rrruark/IOT_Geiger/README.md

http://robruark.com/other/Radiation/Geiger_Counter/v2/geiger_v23.html
