rrruark/IOT_Geiger/Geiger_v3.pdf

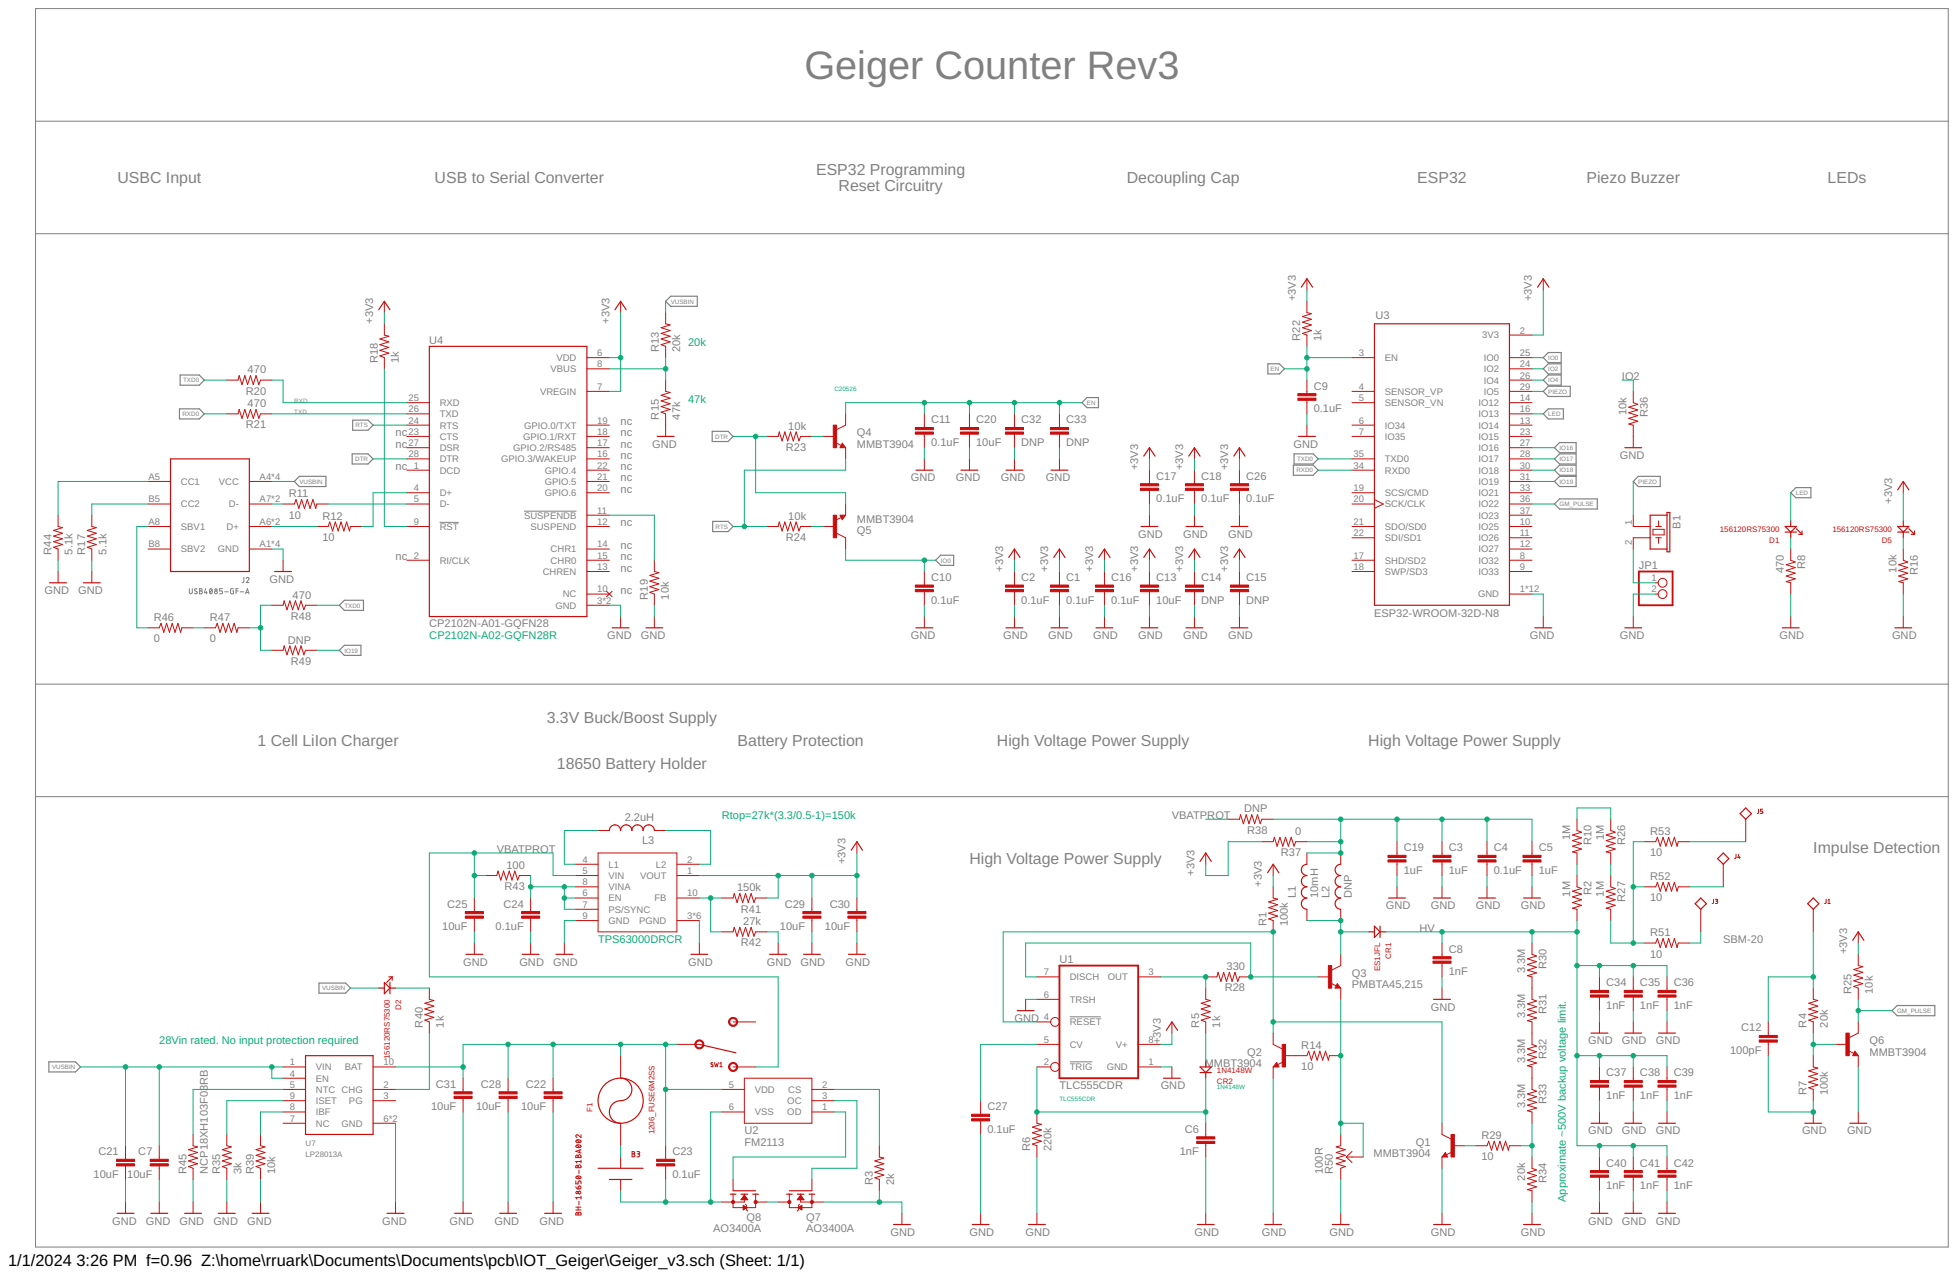
[picture p1: page 1]

High Voltage Power Supply

Approximate ~500V backup voltage limit.

1N4148W 28Vin rated. No input protection required

1/1/2024 3:26 PM f=0.96 Z:\home\rruark\Documents\Documents\pcb\IOT_Geiger\Geiger_v3.sch (Sheet: 1/1)
