rrruark/IOT_Geiger/rev3/Geiger_v3.pdf

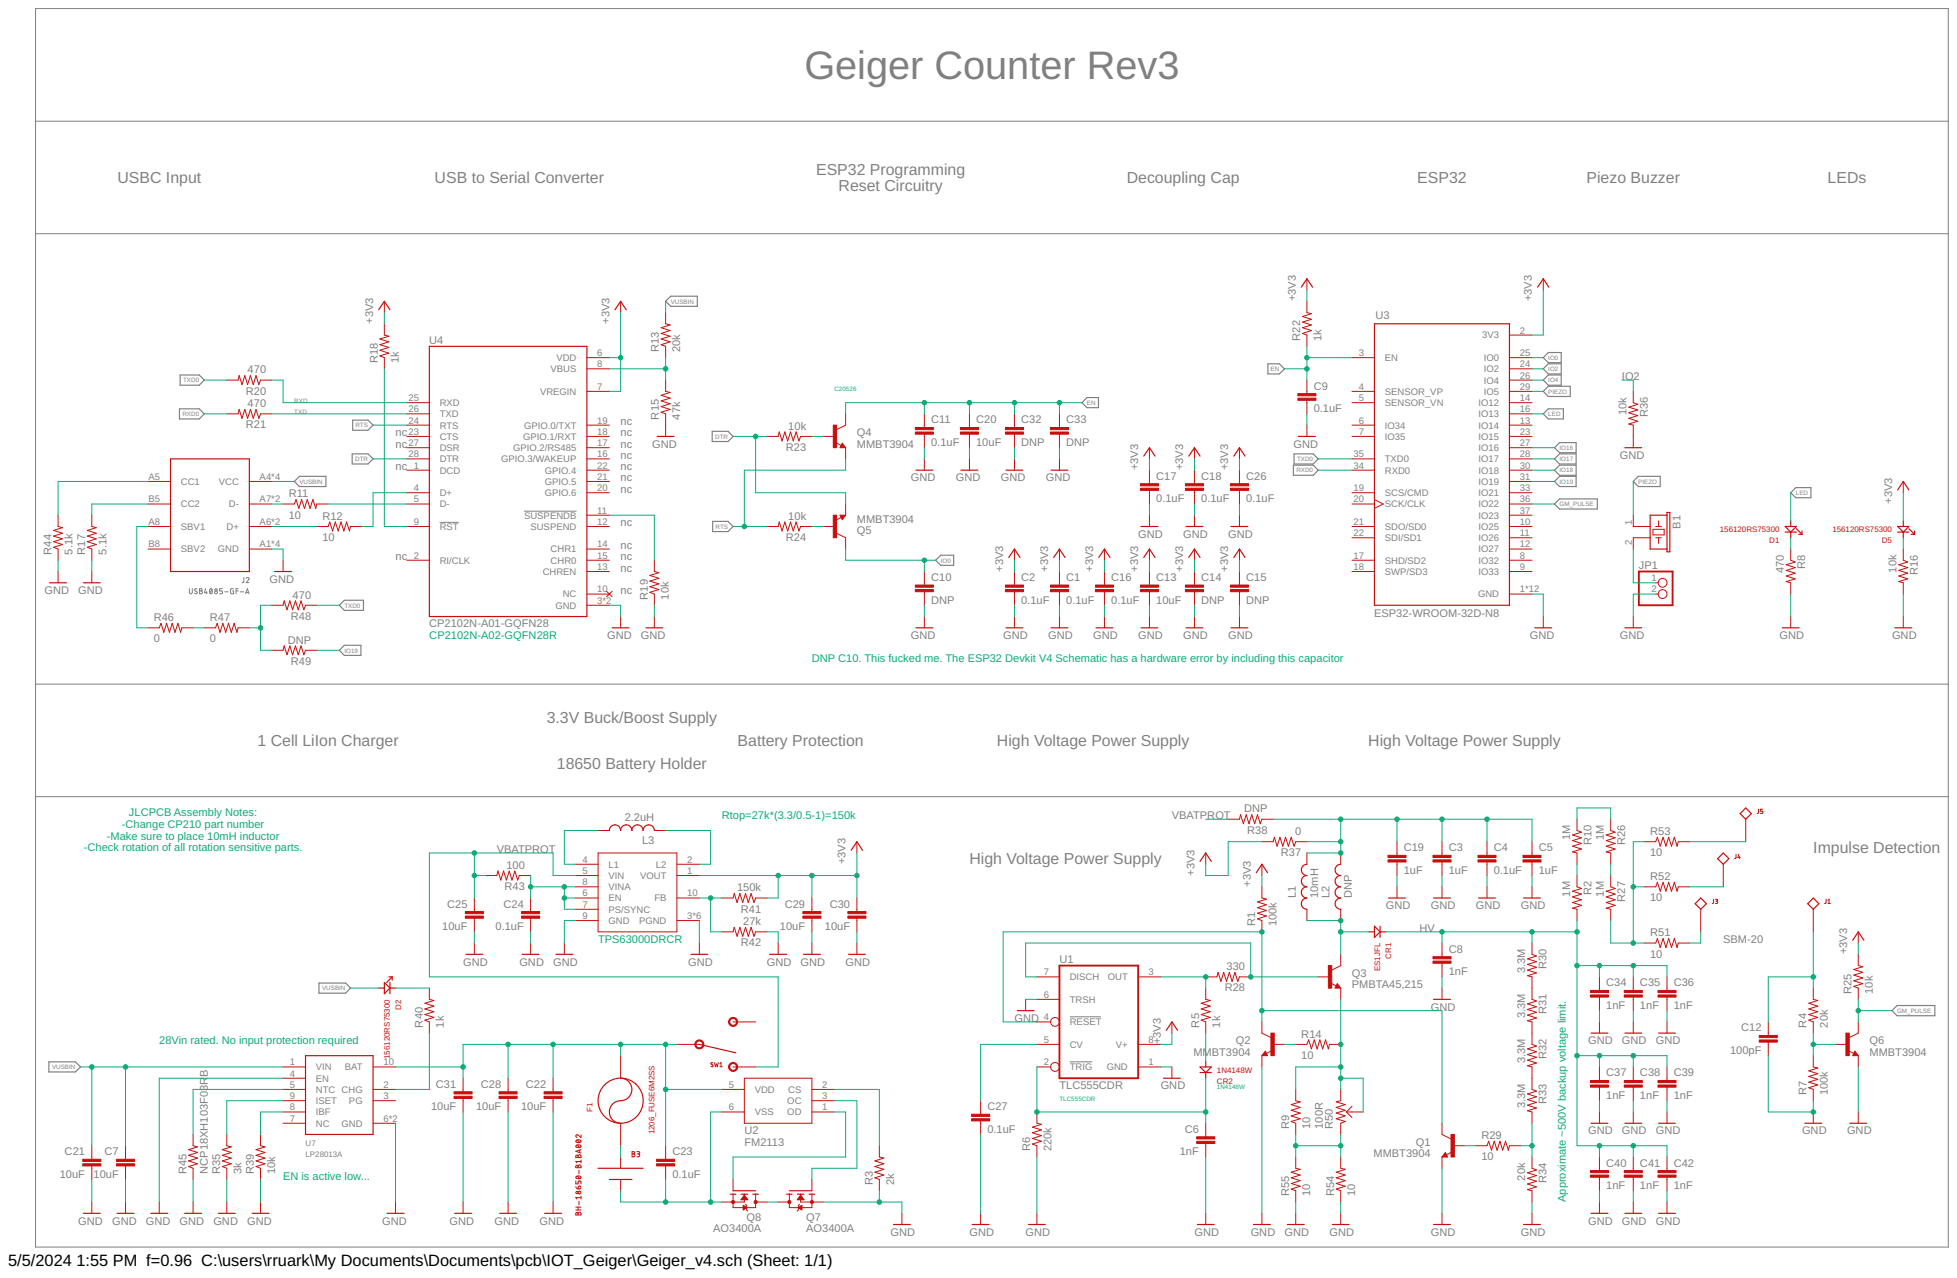
[picture p2: page 1]

DNP C10. This fucked me. The ESP32 Devkit V4 Schematic has a hardware error by including this capacitor

JLCPCB Assembly Notes: -Change CP210 part number

-Make sure to place 10mH inductor
-Check rotation of all rotation sensitive parts.

High Voltage Power Supply

Approximate ~500V backup voltage limit.

1N4148W 28Vin rated. No input protection required

EN is active low...

5/5/2024 1:55 PM f=0.96 C:\users\rruark\My Documents\Documents\pcb\IOT_Geiger\Geiger_v4.sch (Sheet: 1/1)
