rrruark/IOT_Geiger/rev2/Geiger_rev2.pdf

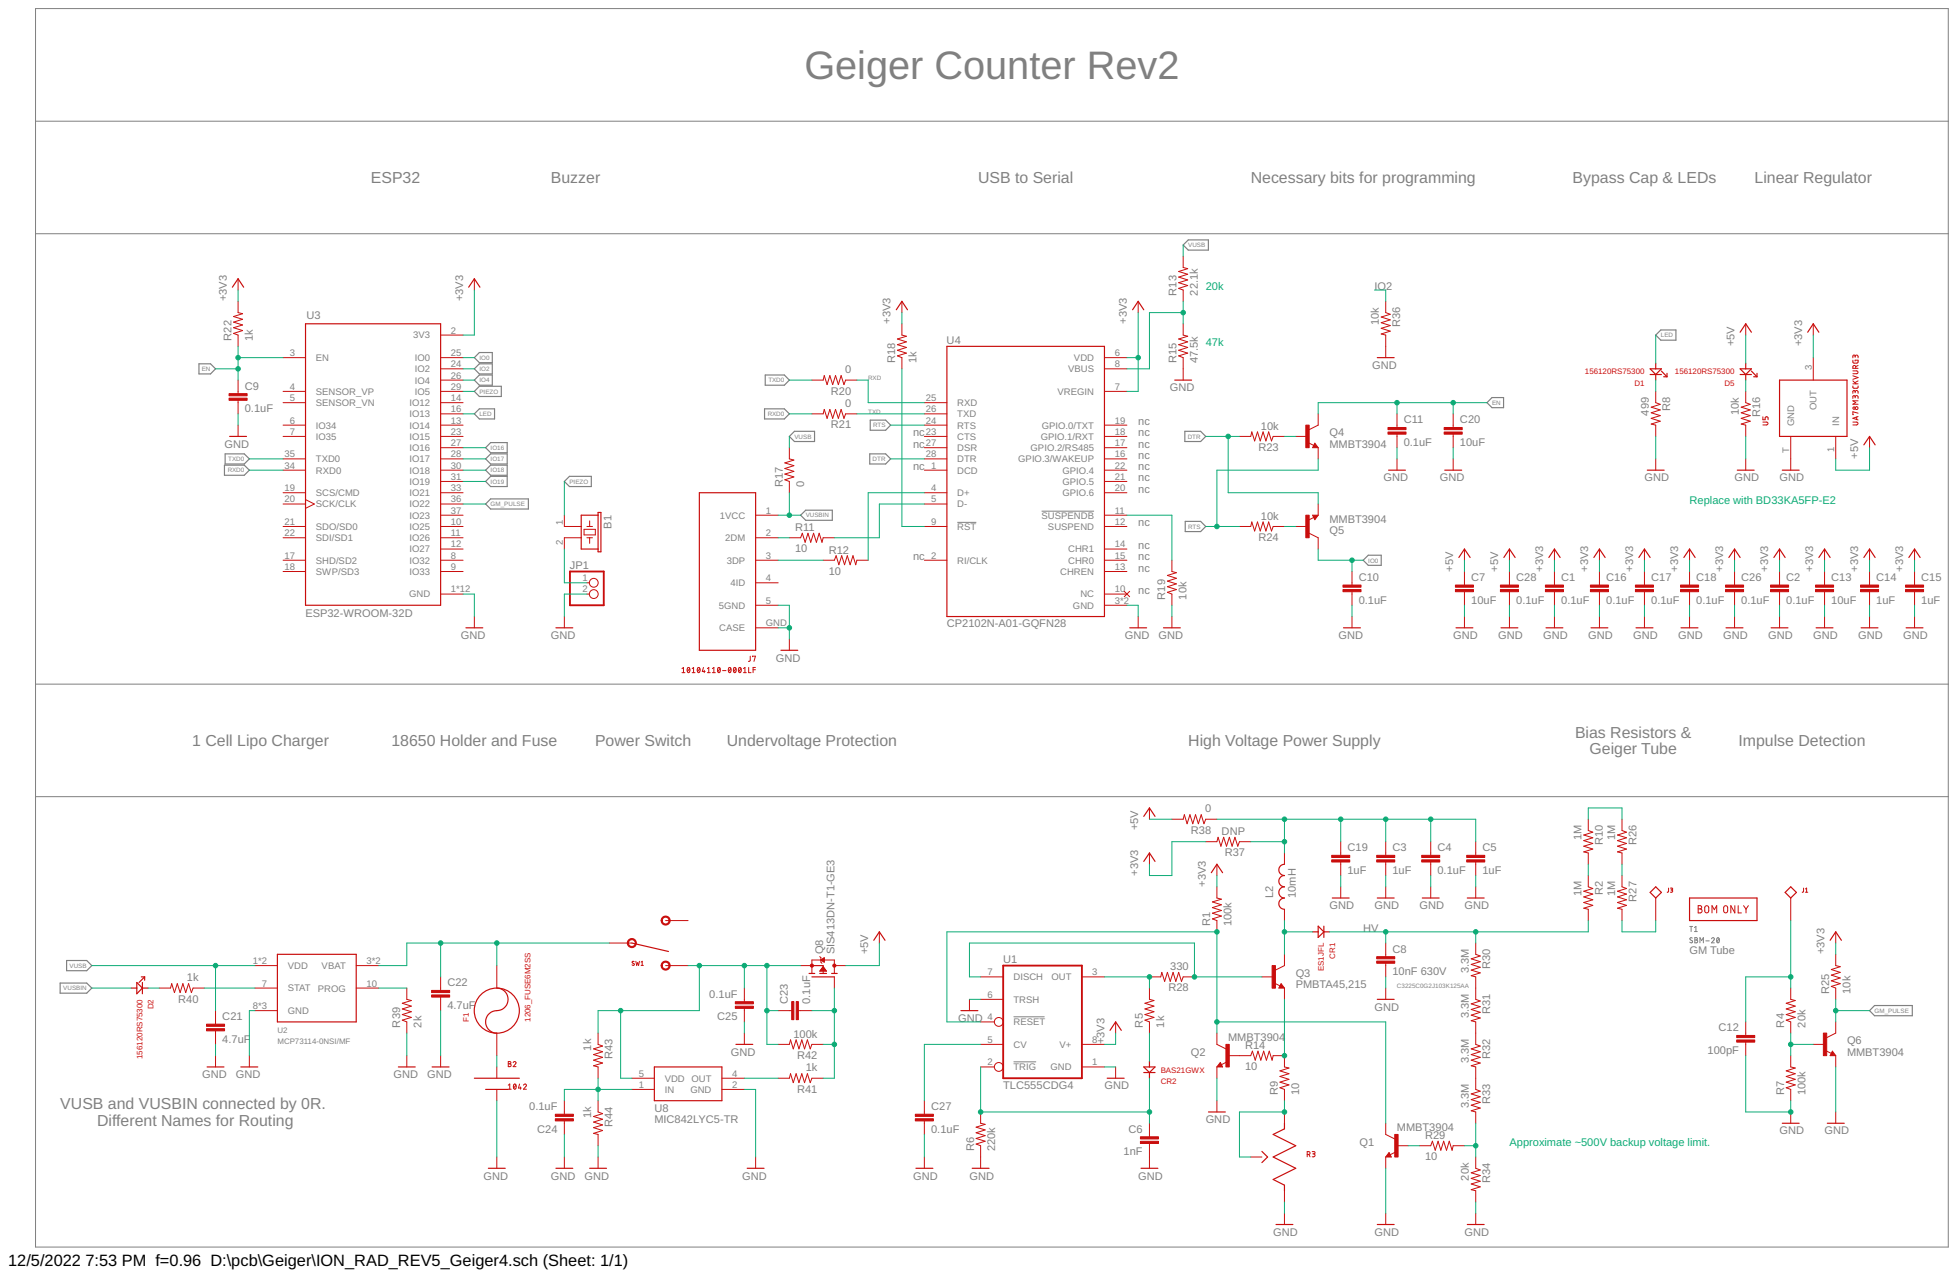
[picture p3: page 1]

VUSB and VUSBIN connected by 0R. Different Names for Routing

Approximate ~500V backup voltage limit.

12/5/2022 7:53 PM f=0.96 D:\pcb\Geiger\ION_RAD_REV5_Geiger4.sch (Sheet: 1/1)
