rrruark/IOT_Geiger/rev1/Geiger_Rev1.pdf

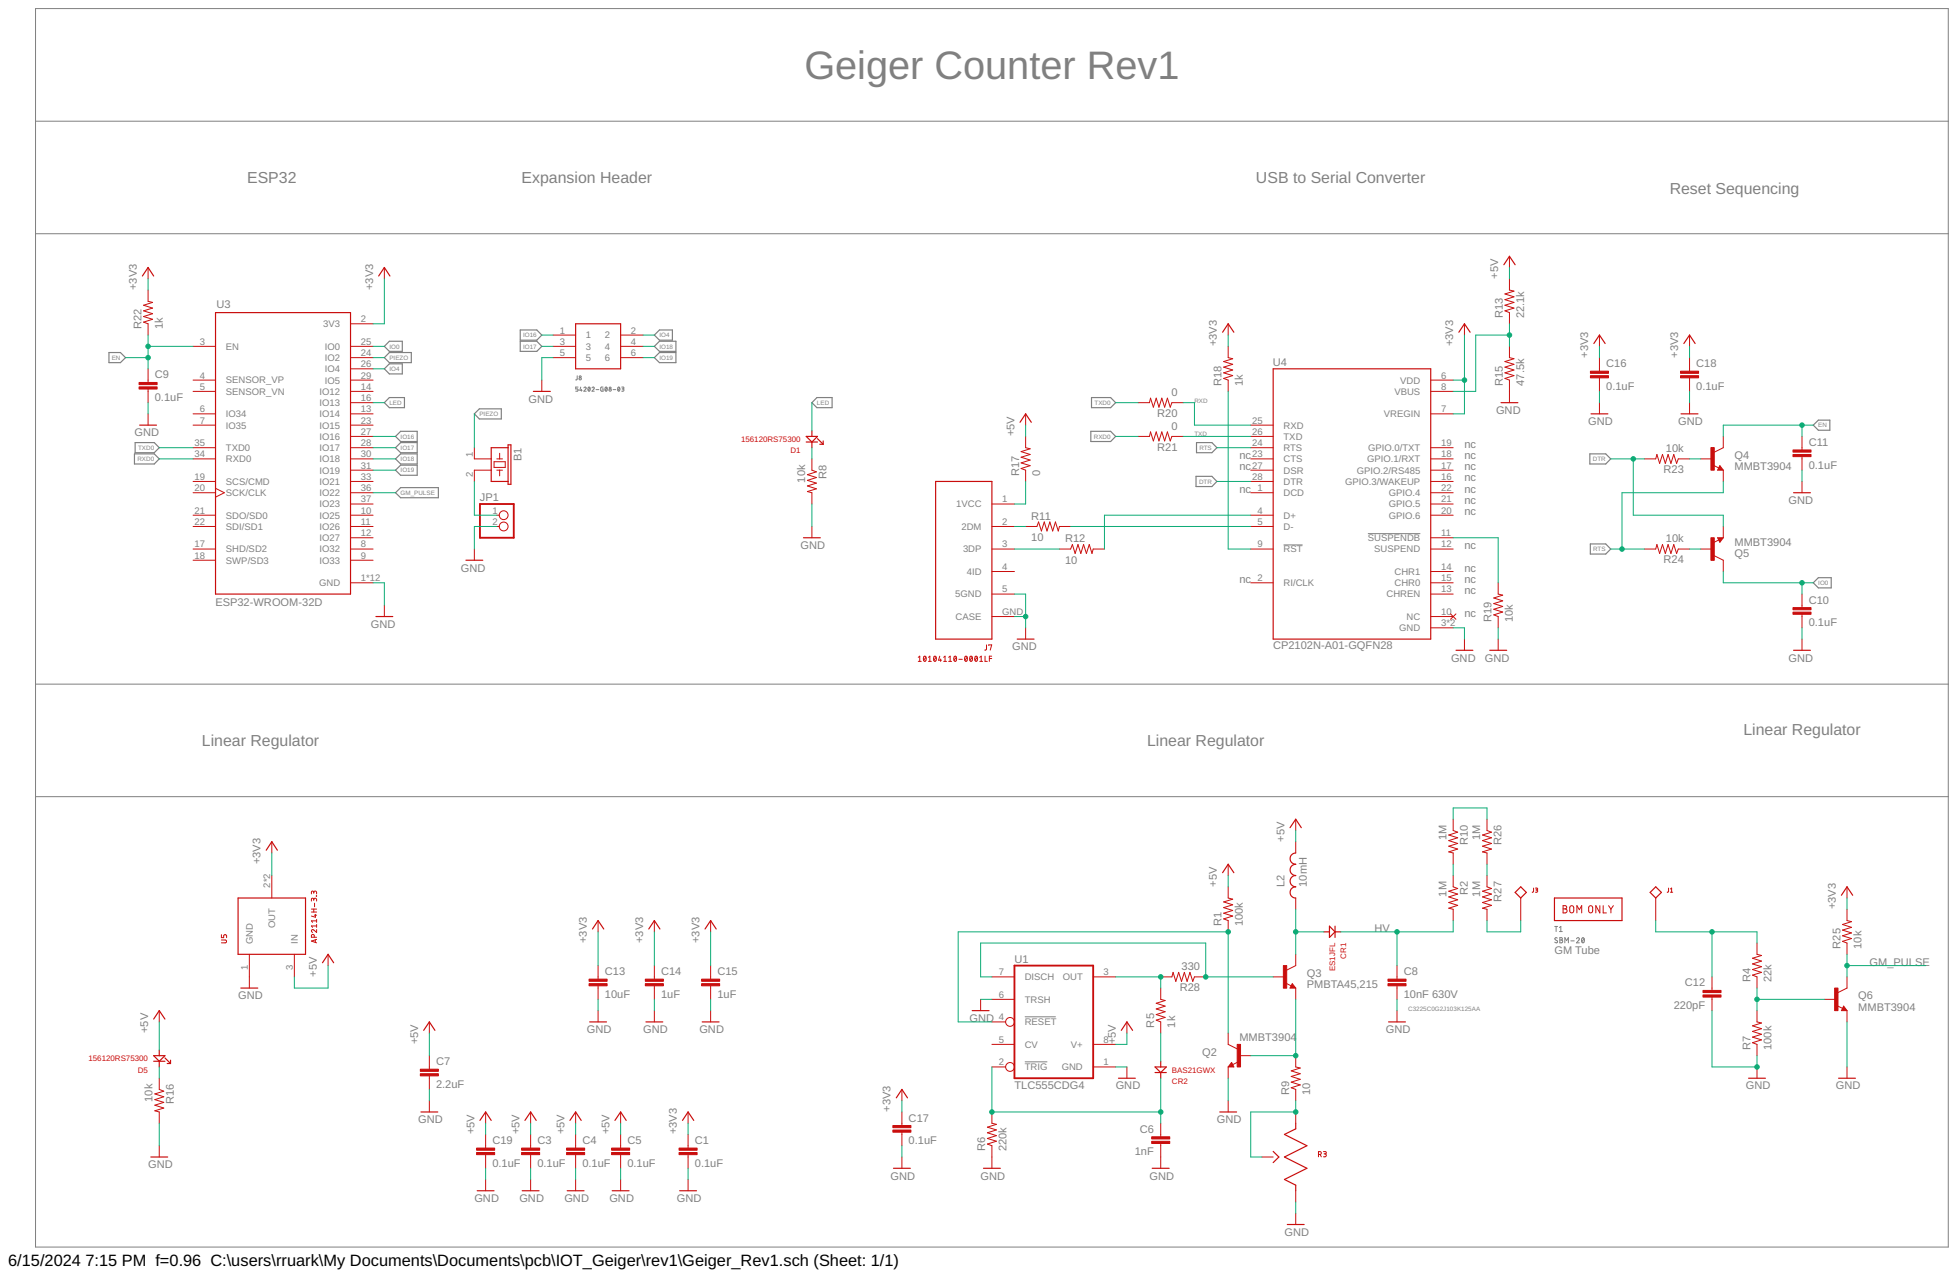
[picture p4: page 1]

6/15/2024 7:15 PM f=0.96 C:\users\rruark\My Documents\Documents\pcb\IOT_Geiger\rev1\Geiger_Rev1.sch (Sheet: 1/1)
