rrruark/IOT_Geiger/rev1/Geiger_Rev1.brd

## EAGLE design rev1/Geiger_Rev1.brd (2024-06-16, an earlier design)

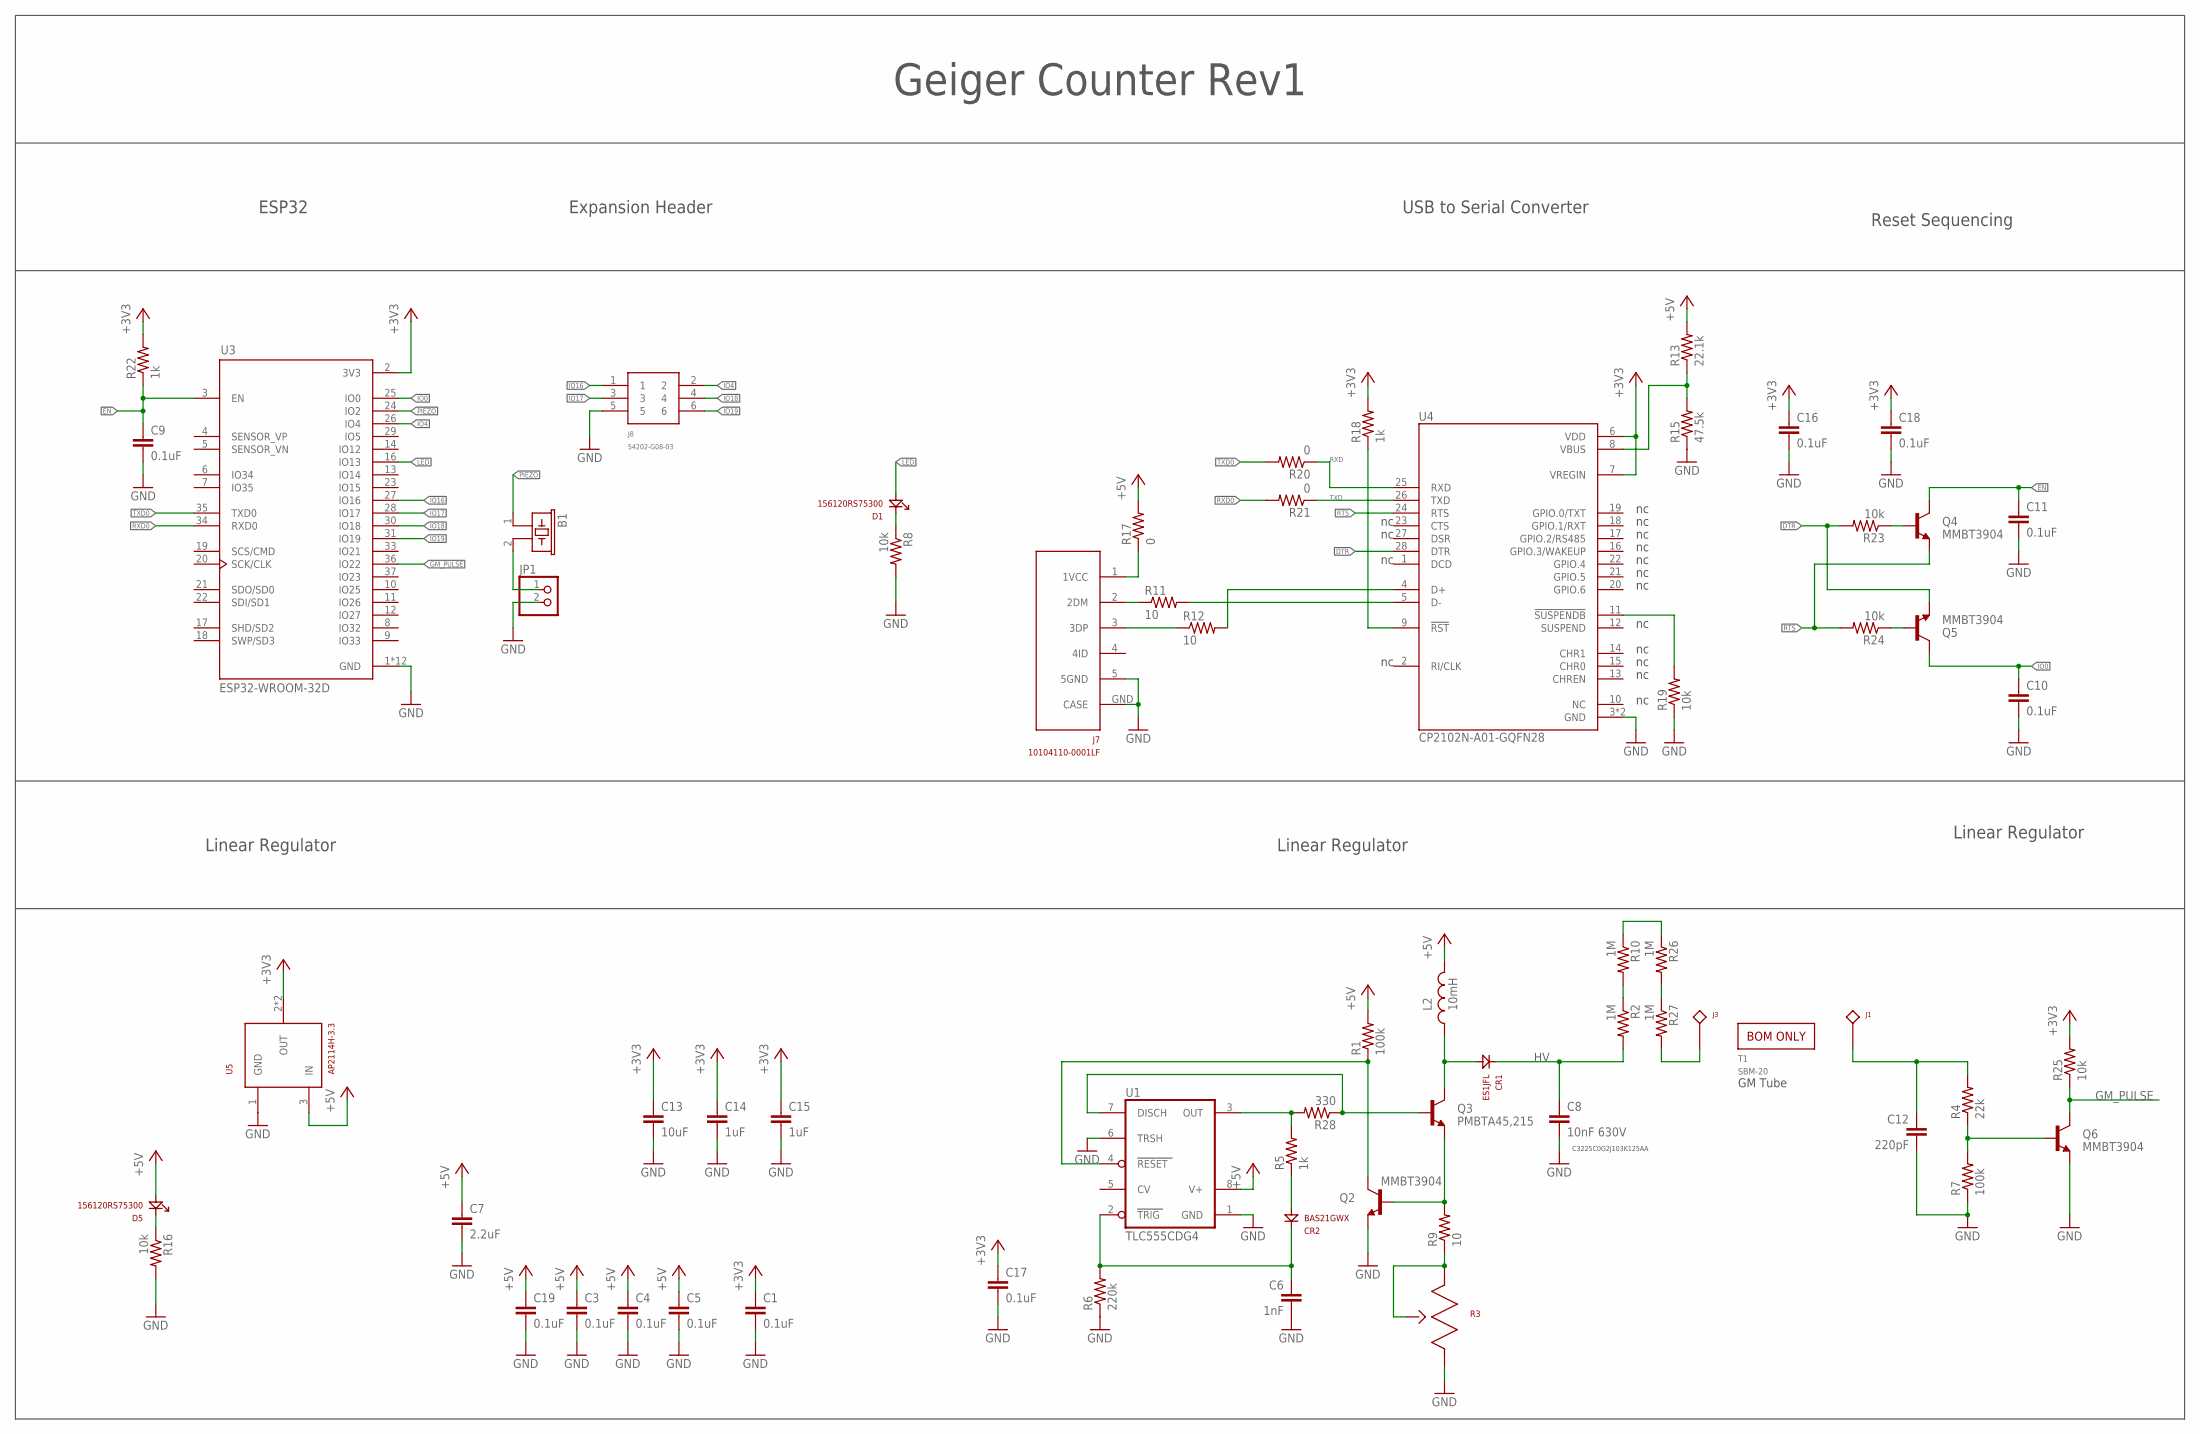
[picture p5: schematic Geiger_Rev1.sch]

Parts:
B1: PIEZO17MM; PS1740P02E
C1, C3, C4, C5, C9, C10, C11, C16, C17, C18, C19: 0.1uF; 0603
C6: 1nF; 0603
C7: 2.2uF; 1210
C8: 10nF 630V; 1210
C12: 220pF; 0603
C13: 10uF; 0805
C14, C15: 1uF; 0805
CR1: ES1JFL; SOD123(AK)
CR2: BAS21GWX; SOD123
D1, D5: 156120RS75300; 1206_REV
J1, J3: 01010002Z
J7: 10104110-0001LF; MICRO_USB
J8: 54202-G08-03; 6-SMT-HEADER
JP1: PINHD-1X2; 1X02
L2: 10mH; SDR1005
Q2, Q4, Q5, Q6: MMBT3904; SOT23-3
Q3: PMBTA45,215; SOT23-3
R1, R7: 100k; 0603
R2, R10, R26, R27: 1M; 0603
R3: 10; 3361P
R4: 22k; 0603
R5, R18, R22: 1k; 0603
R6: 220k; 0603
R8, R16, R19, R23, R24, R25: 10k; 0603
R9: 10; 1206
R11, R12: 10; 0603
R13: 22.1k; 0603
R15: 47.5k; 0603
R17, R20, R21: 0; 0603
R28: 330; 0603
T1: SBM-20
U1: TLC555CDG4; SOIC8
U3: ESP32-WROOM-32D; MODULE_ESP32-WROOM-32D
U4: CP2102N-A01-GQFN28; QFN50P500X500X80-29N
U5: AP2114H-3.3; SOT223

Connections:
+3V3: C1.1, C13.1, C14.1, C15.1, C16.1, C17.1, C18.1, R18.2, R22.2, R25.2, U3.2 (3V3), U4.6 (VDD), U4.7 (VREGIN), U5.2 (OUT), U5.T (OUT)
+5V: C3.1, C4.1, C5.1, C7.1, C19.1, D5.A, L2.P$2, R1.2, R13.2, R17.2, U1.8 (V+), U5.3 (IN)
DTR: Q5.2 (E), R23.2, U4.28 (DTR)
EN: C9.1, C11.1, Q4.3 (C), R22.1, U3.3 (EN)
GM_PULSE: Q6.3 (C), R25.1, U3.36 (IO22)
GND: C1.2, C3.2, C4.2, C5.2, C6.2, C7.2, C8.2, C9.2, C10.2, C11.2, C12.2, C13.2, C14.2, C15.2, C16.2, C17.2, C18.2, C19.2, J7.5 (5GND), J7.GND (CASE), J8.5, JP1.2, Q2.2 (E), Q6.2 (E), R3.3, R6.1, R7.1, R8.2, R15.1, R16.2, R19.1, U1.1 (GND), U1.6 (TRSH), U3.1 (GND), U3.15 (GND), U3.38 (GND), U3.39_1 (GND), U3.39_2 (GND), U3.39_3 (GND), U3.39_4 (GND), U3.39_5 (GND), U3.39_6 (GND), U3.39_7 (GND), U3.39_8 (GND), U3.39_9 (GND), U4.3 (GND), U4.29 (GND), U5.1 (GND)
HV: C8.1, CR1.K, R2.2
IO0: C10.1, Q5.3 (C), U3.25 (IO0)
IO4: J8.2, U3.26 (IO4)
IO16: J8.1, U3.27 (IO16)
IO17: J8.3, U3.28 (IO17)
IO18: J8.4, U3.30 (IO18)
IO19: J8.6, U3.31 (IO19)
LED: D1.A, U3.16 (IO13)
unnamed: CR2.2 (A), R5.1
unnamed: J7.2 (2DM), R11.1
unnamed: Q2.3 (C), R1.1, U1.4 (RESET)
unnamed: J7.3 (3DP), R12.1
unnamed: R11.2, U4.5 (D-)
unnamed: R12.2, U4.4 (D+)
unnamed: R13.1, R15.2, U4.8 (VBUS)
unnamed: Q3.1 (B), R28.1, U1.7 (DISCH)
unnamed: C6.1, CR2.1 (K), R6.2, U1.2 (TRIG)
unnamed: R5.2, R28.2, U1.3 (OUT)
unnamed: Q2.1 (B), Q3.2 (E), R9.2
unnamed: B1.2, JP1.1
unnamed: J7.1 (1VCC), R17.1
unnamed: Q6.1 (B), R4.1, R7.2
unnamed: J3.P$1, R27.2
unnamed: R2.1, R10.2
unnamed: R10.1, R26.1
unnamed: R18.1, U4.9 (!RST)
unnamed: D5.K, R16.1
unnamed: R19.2, U4.11 (!SUSPENDB)
unnamed: R26.2, R27.1
unnamed: Q4.1 (B), R23.1
unnamed: R3.1, R3.2, R9.1
unnamed: Q5.1 (B), R24.1
unnamed: D1.K, R8.1
unnamed: C12.1, J1.P$1, R4.2
PIEZO: B1.1, U3.24 (IO2)
RTS: Q4.2 (E), R24.2, U4.24 (RTS)
RXD: R20.1, U4.25 (RXD)
RXD0: R21.2, U3.34 (RXD0)
SW: CR1.A, L2.P$1, Q3.3 (C)
TXD: R21.1, U4.26 (TXD)
TXD0: R20.2, U3.35 (TXD0)

Notes on the sheet:
Geiger Counter Rev1
Linear Regulator
GM Tube
C3225C0G2J103K125AA
ESP32
Expansion Header
USB to Serial Converter
Reset Sequencing

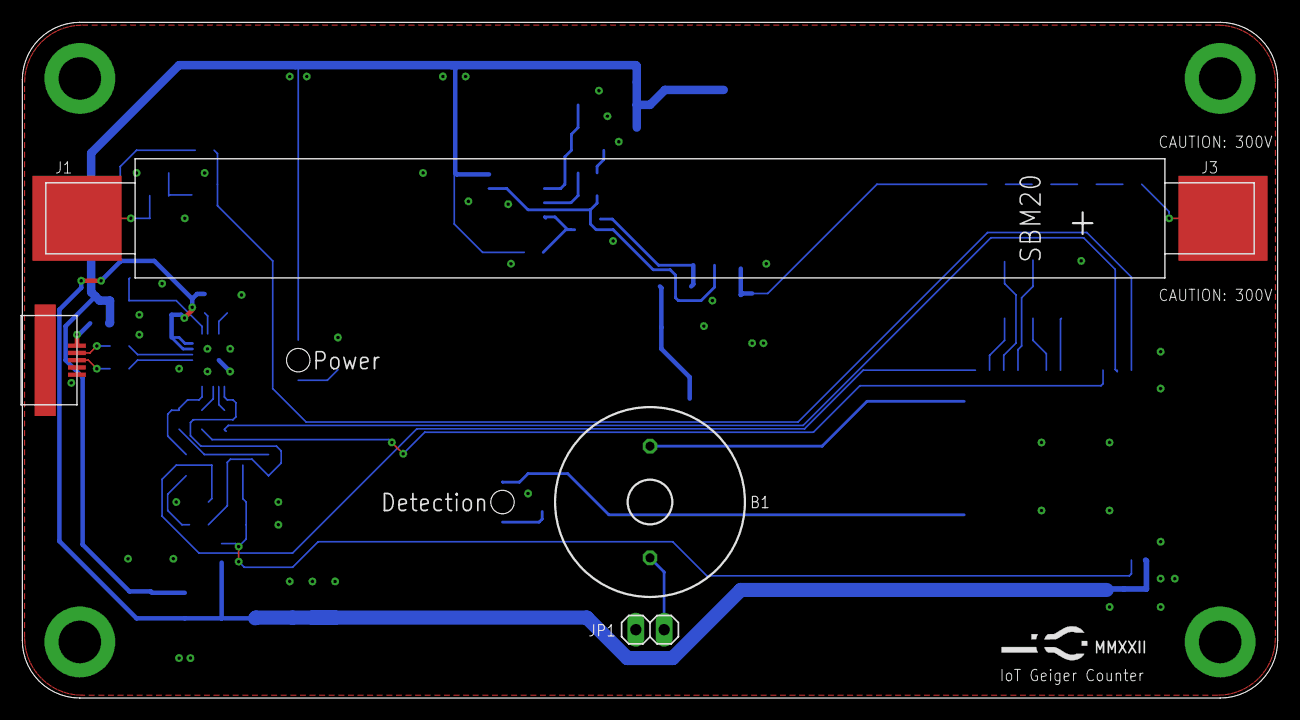
[picture p6: board Geiger_Rev1.brd from above]

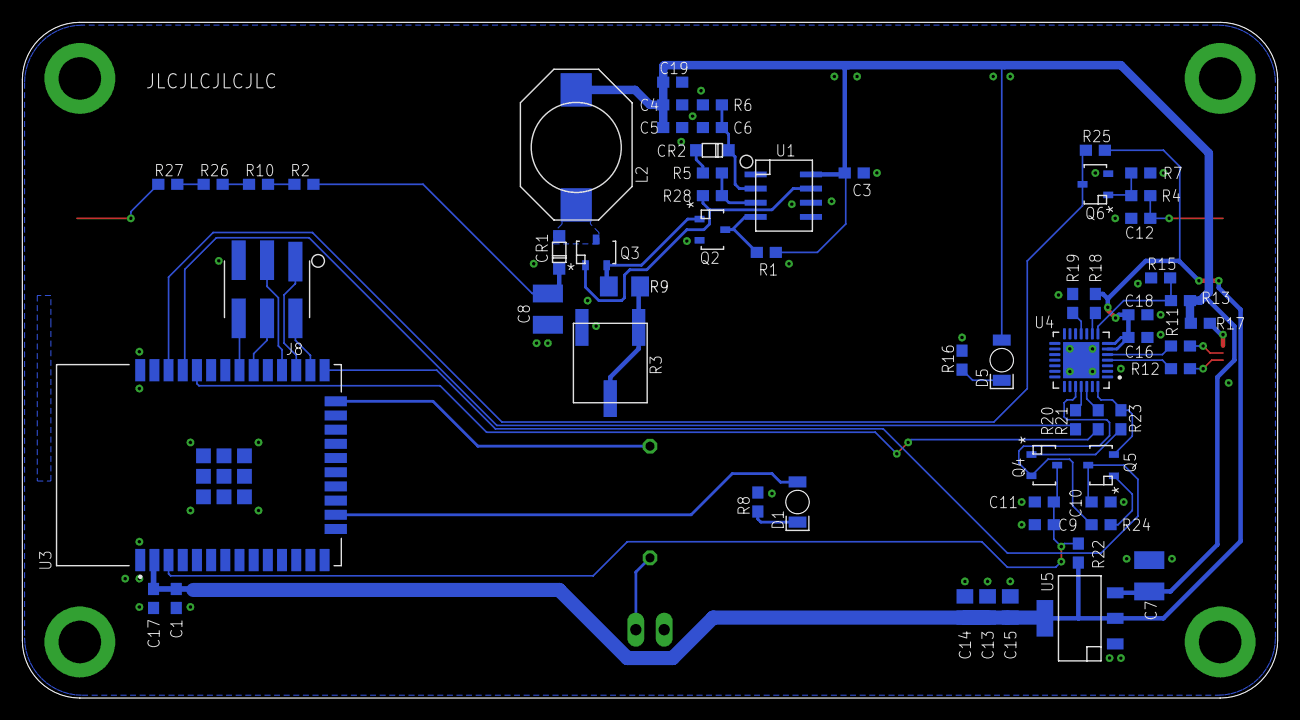
[picture p7: board Geiger_Rev1.brd from below]

Board: 2 copper layers, 112.4 x 60.5 mm, 66 parts (60 on the bottom side), 47 nets.
