rrruark/IOT_Geiger/(commit log)

2024-06-16 Directory cleanup
    [Geiger_Rev1.brd, Geiger_Rev1.sch, Geiger_v3.brd, Geiger_v3.sch, Geiger_v3_bottom_bom.csv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]
2024-06-16 Adding Arduino code
